AndreiVladescu/LibrePLC32/plc/kicad/LibrePLC32.kicad_pcb

## KiCad design plc/kicad/LibrePLC32.kicad_pcb (2026-08-19)

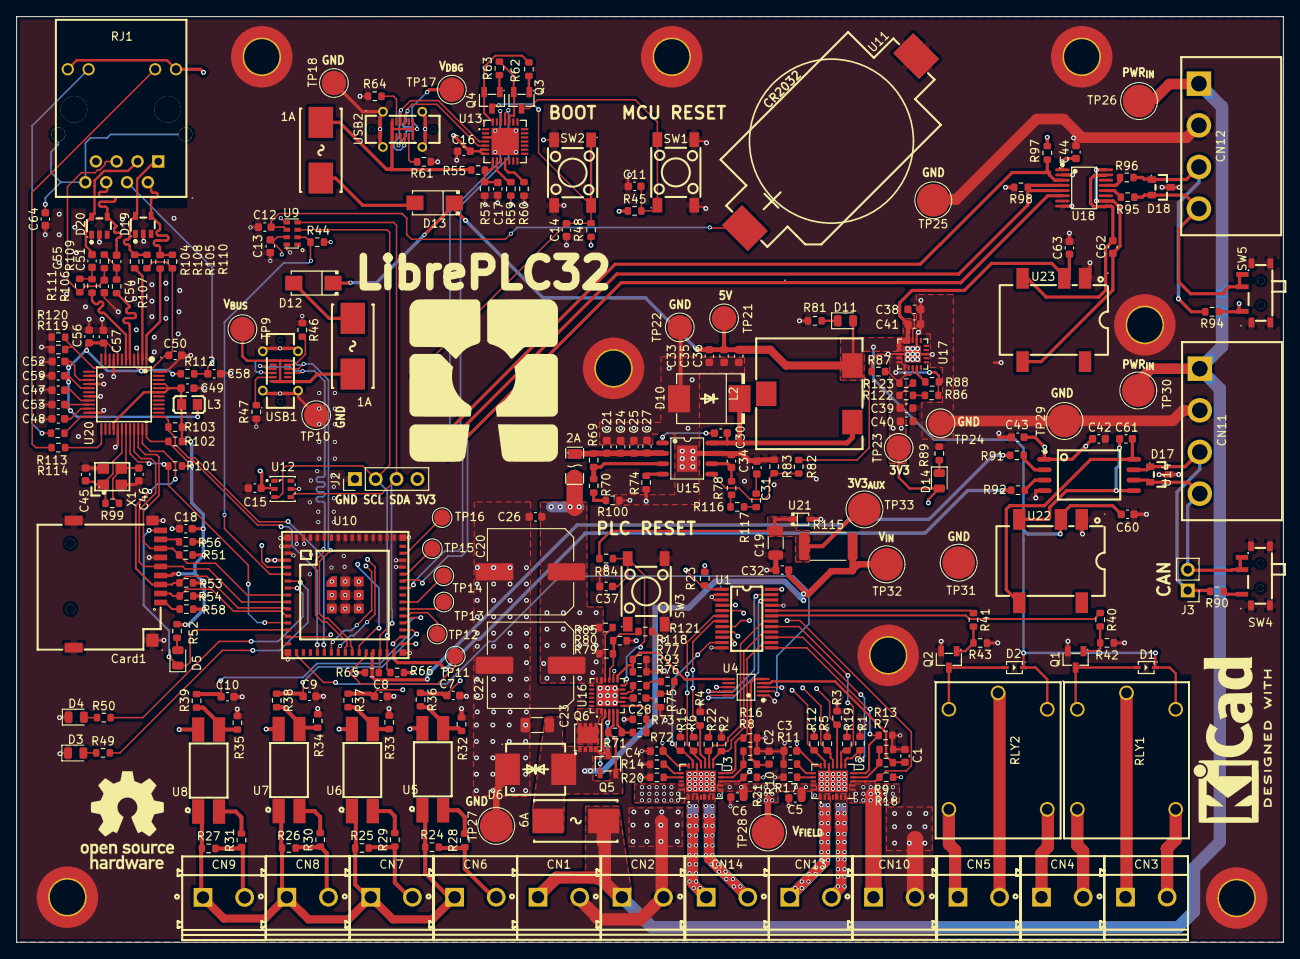
[picture p1: board LibrePLC32.kicad_pcb from above]

Board: 4 copper layers, 154.5 x 112.9 mm, 292 parts (0 on the bottom side), 185 nets.

Parts:
C1, C2: 100p; C_0603_1608Metric
C3, C4, C21, C24, C25, C27: 2.2u; C_0603_1608Metric
C5, C6, C11, C12, C13, C14, C15, C18, C26, C28, C30, C32, C37, C39, C42, C44, C49, C50, C52, C53, C56, C57, C59: 100n; C_0603_1608Metric
C7, C8, C9, C10, C64: 1n; C_0603_1608Metric
C16, C38, C61, C62: 10u; C_0603_1608Metric
C17, C43: 1u; C_0603_1608Metric
C19, C23: 2.2u; C_1206_3216Metric
C20, C22: 220u; C_Elec_10x10.2
C31: 4.7n; C_0603_1608Metric
C33, C35, C36: 47u; C_0603_1608Metric
C34: 47p; C_0603_1608Metric
C40, C41: 22u; C_0603_1608Metric
C45, C46: 27p; C_0603_1608Metric
C47, C60, C63: 4.7u; C_0603_1608Metric
C48, C54: 10n; C_0603_1608Metric
C51, C55: 6.8n; C_0603_1608Metric
C58: 22n; C_0603_1608Metric
CN1, CN2, CN3, CN4, CN5, CN6, CN7, CN8, CN9, CN10, CN13, CN14: DB128V-5.08-2P-GN-S; CONN-TH_2P-P5.08_DIBO_DB128V-5.08
CN11, CN12: DB2ERC-5.08-4P; CONN-TH_4P-P5.08_DB2ERC-5.08-4P
Card1: TF PUSH; TF-SMD_TF-PUSH
D1, D2: 1N4148WS; SOD-323_L1.8-W1.3-LS2.7-RD
D3, D4, D5, D11, D14: LED; LED_0805_2012Metric
D6: SMCJ36CA; SMC_L6.9-W5.9-LS7.9-BI
D10: B560C; SMC_L6.9-W5.9-LS7.9-RD
D12, D13: SS34; SMA_L4.3-W2.7-LS5.1-RD
D17: SM24CANA-02HTG; SOT-23_L2.9-W1.3-P1.90-LS2.4-BR
D18: CDSOT23-SM712; SOT-23_L2.9-W1.3-P1.90-LS2.4-BR
D19, D20: TS3314PLX; SOT-23-5_L2.9-W1.6-P0.95-LS2.8-BR
F2: BSMD1206C-1200T; F1206
FH1, FH2, FH3: 01550900M; FUSE-SMD_L9.8-W5.0_01550900M
H1, H2, H3, H4, H5, H6, H7, H8: MountingHole_Pad; MountingHole_4.3mm_M4_DIN965_Pad_TopBottom
J2: Conn_01x04_Pin; PinHeader_1x04_P2.54mm_Vertical
J3: Conn_01x02_Pin; PinHeader_1x02_P2.54mm_Vertical
L2: 7.2u; IND-SMD_3P-L13.5-W13.0-P6.9
L3: BLM21PG300SN1D; L0805
Q1, Q2: AO3400A; SOT-23-3_L2.9-W1.3-P1.90-LS2.4-BR
Q3, Q4: L8050QLT1G; SOT-23-3_L2.9-W1.3-P1.90-LS2.4-BR
Q5: BSS138LT1G; SOT-23-3_L2.9-W1.6-P1.90-LS2.8-BR
Q6: CSD19537Q3; DFN-8_L3.3-W3.3-P0.65-BL-3
R1, R2, R3, R4, R5, R6, R13, R16, R19, R22, R42, R43, R69, R79, R85, R88: 100k; R_0603_1608Metric
R7, R8, R117: 620; R_0603_1608Metric
R9, R10, R12, R15, R18, R21, R23, R32, R33, R34, R35, R45, R48, R51, R53, R54, R56, R57, R58, R60, R62, R63, R70, R78, R80, R83, R84, R86, R97, R98, R100, R101, R102, R103, R121: 10k; R_0603_1608Metric
R11, R14, R17, R20, R44, R46, R47, R55, R61, R64, R65, R66, R87, R122: 5.1k; R_0603_1608Metric
R24, R25, R26, R27, R28, R29, R30, R31, R77, R116, R118, R119, R120: 6.2k; R_0603_1608Metric
R36, R37, R38, R39, R40, R41, R59, R75, R76, R81, R93, R123: 1k; R_0603_1608Metric
R49, R50, R52, R89, R113, R114: 470; R_0603_1608Metric
R71: 383k; R_0603_1608Metric
R72: 56k; R_0603_1608Metric
R73: 15k; R_0603_1608Metric
R74: 243k; R_0603_1608Metric
R82: 52.5k; R_0603_1608Metric
R90, R94: 120; R_0603_1608Metric
R91, R92: 0; R_0603_1608Metric
R95, R96, R112: 10; R_0603_1608Metric
R99: 1M; R_0603_1608Metric
R104, R105, R106, R107: 33; R_0603_1608Metric
R108, R109, R110, R111: 49; R_0603_1608Metric
R115: 3k; R_2512_6332Metric
RJ1: HR913129A; RJ45-TH_HR913129A
RLY1, RLY2: HF3FF/005-1ZTF; RELAY-TH_HF3FF-018-1ZT
SW1, SW2, SW3: TSD003B08026A03; SW-SMD_4P-L6.0-W6.0-P4.50-LS8.6
SW4, SW5: MSK12C02; SW-TH_MSK12C02
TP9, TP10, TP17, TP18, TP21, TP22, TP23, TP24: TestPoint; TestPoint_Pad_D3.0mm
TP11, TP12, TP13, TP14, TP15, TP16: TestPoint; TestPoint_Pad_D2.0mm
TP25, TP26, TP27, TP28, TP29, TP30, TP31, TP32, TP33: TestPoint; TestPoint_Pad_D4.0mm
U1: TCA9535PWR; TSSOP-24_L7.8-W4.4-P0.65-LS6.4-BL
U2, U3: TPS272C45DRHFR; VQFN-24_L5.0-W4.0-P0.50-BL-EP-1
U4: ADS1115IDGSR; MSOP-10_L3.0-W3.0-P0.50-LS5.0-BL
U5, U6, U7, U8: LTV-814S-TA1-A; OPTO-SMD-4_L4.6-W6.5-P2.54-LS10.3-BL
U9: RV-3028-C7; OSC-SMD_8P-L3.2-W1.5-P0.90-BL
U10: ESP32-S3-MINI-1U; BULETM-SMD_ESPRESSIF_ESP32-S3-MINI-1U-N8
U11: BS-0601-SK-4W; BAT-SMD_BS-06-B4AA012
U12: AHT20; SENSOR-SMD_L3.0-W3.0-P1.00-BR
U13: CP2102N-A02-GQFN28R; QFN-28_L5.0-W5.0-P0.50-TL-EP3.3
U14: ISO1042BDWVR; SOIC-8_L5.9-W7.5-P1.27-LS11.5-BL
U15: TPS54560BDDAR; POWERPAD-SO-8_L4.9-W3.9-P1.27-LS6.0-BL-EP
U16: TPS26630RGER; TQFN-24_L4.0-W4.0-P0.50-TL-EP
U17: TPS7A5201QRGRRQ1; VQFN-20_L3.5-W3.5-P0.50-TL-EP
U18: ISO1500DBQR; SSOP-16_L4.9-W3.9-P0.64-LS6.0-BL
U20: W5500; LQFP-48_L7.0-W7.0-P0.50-LS9.0-BL
U21: BZT52C3V3S; SOD-323_L1.7-W1.3-LS2.5-RD-1
U22, U23: B0505XT-1WR3; PWRM-SMD_BXXXXXT-1WR3
USB1, USB2: GT-USB-7055BB; USB-C-TH_GT-USB-7055BB
X1: X322525MRB4SI; OSC-SMD_4P-L3.2-W2.5-BL_SIT8008BI

Connections:
+3V3: C3.1, C4.1, C13.2, C15.1, C16.2, C18.2, C39.2, C40.2, C42.1, C43.1, C44.1, C49.1, Card1.4 (VDD), D14.2 (A), J2.4, L3.1, R12.1, R15.1, R18.1, R19.1, R21.1, R22.1, R23.1, R44.2, R45.1, R48.1, R51.2, R52.2, R53.2, R54.2, R56.2, R58.2, R59.1, R65.1, R66.1, R86.1, R88.2, R97.1, R101.1, R102.1, R103.1, RJ1.9 (LED(G)_A), RJ1.12 (LED(Y)_A), TP23.1 (1_1), U1.24 (VCC), U2.19 (VDD), U3.19 (VDD), U4.8 (VDD), U5.4, U6.4, U7.4, U8.4, U9.7 (VDD), U10.3 (3V3), U12.2 (VDD), U13.6 (VDD), U13.7 (VREGIN), U14.1 (VCC1), U17.1 (OUT), U17.19 (OUT), U17.20 (OUT), U18.1 (VCC1), U20.28 (VDD), U20.43 (PMODE2), U20.44 (PMODE1), U20.45 (PMODE0)
+3V3A: C50.1, C52.1, C53.1, C56.1, C57.1, C59.1, L3.2, R108.2, R110.2, R112.1, U20.4 (AVDD), U20.8 (AVDD), U20.11 (AVDD), U20.15 (AVDD), U20.17 (AVDD), U20.21 (AVDD)
+3V3_AUX: C19.1, R84.1, R115.1, TP33.1 (1_1), U21.1
+5V: C33.2, C35.2, C36.2, C41.2, C60.1, C63.1, D1.1 (K), D2.1 (K), D11.2 (A), D12.1 (C), D13.1 (C), L2.2, R82.1, RLY1.4, RLY2.4, TP21.1 (1_1), U17.14 (EN), U17.15 (IN), U17.16 (IN), U17.17 (IN), U22.2 (Vin), U23.2 (Vin)
/CAN/CAN_H: CN11.3, D17.1, J3.1, R90.2, U14.7 (CANH)
/CAN/CAN_L: CN11.4, D17.2, J3.2, SW4.2, SW4.3, U14.6 (CANL)
/CAN/CAN_RX: R92.2, U10.30 (IO48)
/CAN/CAN_TX: R91.2, U10.27 (IO47)
/Ethernet/ETH_1V2: C48.1, U20.22 (1V2O)
/Ethernet/ETH_EXPRES: R119.1, R120.1, U20.10 (EXRES1)
/Ethernet/ETH_LED_G: R114.2, U20.25 (LINKLED)
/Ethernet/ETH_LED_Y: R113.2, U20.24 (SPDLED)
/Ethernet/ETH_RX+: R106.1, U20.6 (RXP)
/Ethernet/ETH_RX-: R107.1, U20.5 (RXN)
/Ethernet/ETH_TOCAP: C47.1, U20.20 (TOCAP)
/Ethernet/ETH_TX+: R104.1, U20.2 (TXP)
/Ethernet/ETH_TX-: R105.1, U20.1 (TXN)
/Ethernet/ETH_XI: C45.2, R99.1, U20.30 (XI/CLKIN), X1.1 (OSC1)
/Ethernet/ETH_XO: C46.1, R99.2, U20.31 (XO), X1.3 (OSC2)
/Ethernet/RJ45_RCT: C54.1, R109.1, R111.1, RJ1.5 (RCT)
/Ethernet/RJ45_RX+: C55.2, D20.5, RJ1.3 (RD+)
/Ethernet/RJ45_RX-: C51.2, D20.4, RJ1.6 (RD-)
/Ethernet/RJ45_TCT: C58.1, R112.2, RJ1.4 (TCT)
/Ethernet/RJ45_TX+: D19.5, R104.2, R108.1, RJ1.1 (TD+)
/Ethernet/RJ45_TX-: D19.4, R105.2, R110.1, RJ1.2 (TD-)
/Ethernet/RXN: C51.1, R107.2, R109.2
/Ethernet/RXP: C55.1, R106.2, R111.2
/Ethernet/SPI_MISO: Card1.7 (DAT0), R51.1, U10.8 (IO4), U20.34 (MISO)
/Ethernet/SPI_MOSI: Card1.3 (CMD), R53.1, U10.10 (IO6), U20.35 (MOSI)
/Ethernet/SPI_SCLK: Card1.5 (CLX), U10.9 (IO5), U20.33 (SCLK)
/Ethernet/~ETH_CS: R101.2, U10.12 (IO8), U20.32 (SCSn)
/Ethernet/~ETH_INT: R102.2, U10.19 (IO15), U20.36 (INTn)
/Ethernet/~ETH_RST: R103.2, U10.20 (IO16), U20.37 (RSTn)
/MCU/ADC_RDY: U4.2 (ALERT/RDY), U10.16 (IO12)
/MCU/I2C_SCL: J2.2, R66.2, U1.22 (SCL), U4.10 (SCL), U9.3 (SCL), U10.29 (IO34), U12.3 (SCL)
/MCU/I2C_SDA: J2.3, R65.2, U1.23 (SDA), U4.9 (SDA), U9.4 (SDA), U10.28 (IO33), U12.4 (SDA)
/MCU/MCU_DI1: C7.1, R36.1, U10.31 (IO35)
/MCU/MCU_DI2: C8.1, R37.1, U10.32 (IO36)
/MCU/MCU_DI3: C9.1, R38.1, U10.33 (IO37)
/MCU/MCU_DI4: C10.1, R39.1, U10.34 (IO38)
/MCU/MCU_USB_D+: U10.24 (USB_D+), USB1.A6 (D+), USB1.B6 (D+)
/MCU/MCU_USB_D-: U10.23 (USB_D-), USB1.A7 (D-), USB1.B7 (D-)
/MCU/SD_CD: Card1.CD, D5.1 (K), U10.13 (IO9)
/MCU/SD_DAT1: Card1.8 (DAT1), R56.1
/MCU/SD_DAT2: Card1.1 (DAT2), R58.1
/MCU/S_LED0: R49.2, U10.6 (IO2)
/MCU/S_LED1: R50.2, U10.7 (IO3)
/MCU/UART_DTR: Q4.2 (E), R62.2, U13.28 (DTR)
/MCU/UART_RTS: Q3.2 (E), R63.2, U13.24 (RTS)
/MCU/UART_RX: U10.40 (RXD0), U13.25 (RXD)
/MCU/UART_TX: U10.39 (TXD0), U13.26 (TXD)
/MCU/USB_D+: U13.4 (D+), USB2.A6 (D+), USB2.B6 (D+)
/MCU/USB_D-: U13.5 (D-), USB2.A7 (D-), USB2.B7 (D-)
/MCU/~MCU_BOOT: C14.2, Q4.3 (C), R48.2, SW2.1, SW2.2, U10.4 (IO0)
/MCU/~MCU_RST: C11.2, Q3.3 (C), R45.2, SW1.1, SW1.2
/MCU/~RTC_INT: R44.1, U9.2 (~INT), U10.5 (IO1)
/MCU/~SD_CS: Card1.2 (CD/DAT3), R54.1, U10.11 (IO7)
/Power/FB: R82.2, R83.1, U15.5 (FB)
/Power/MAIN_FB: R87.1, R123.2, U17.3 (FB)
/Power/MAIN_PG: R88.1, U17.4 (PG)
/Power/PPIC_BGATE: Q5.3 (D), Q6.4 (G), U16.3 (BGATE)
/Power/PPIC_DRV: Q5.1 (G), U16.4 (DRV)
/Power/PPIC_ILIM: R93.1, U16.10 (ILIM)
/Power/PPIC_IMON: R77.1, R118.1, U4.6 (AIN2), U16.13 (IMON)
/Power/PPIC_IN: Q6.5 (D), Q6.6 (D), Q6.7 (D), Q6.8 (D), Q6.9 (D), U16.1 (IN), U16.2 (IN)
/Power/PPIC_OVP: R72.2, R73.1, U16.7 (OVP)
/Power/PPIC_PGOOD: R85.2, U16.16 (PGOOD)
/Power/PPIC_PGTH: R79.2, R80.1, R121.1, U16.15 (PGTH)
/Power/PPIC_UVLO: R71.2, R72.1, U16.6 (UVLO)
/Power/PPIC_dVdT: C28.2, U16.9 (dVdT)
/Power/V_IN_MAIN: C23.2, C32.2, D6.2, FH1.2, Q5.2 (S), Q6.1 (S), Q6.2 (S), Q6.3 (S), R71.1, R115.2, TP32.1 (1_1), U16.5 (IN_SYS)
/Power/~PPIC_SHDN: C37.2, R84.2, SW3.2, U16.12 (~SHDN)
/RS-485/EXT_RS485_A: CN12.4, D18.2, R95.1, SW5.2, SW5.3
/RS-485/EXT_RS485_B: CN12.3, D18.1, R94.2, R96.1
/RS-485/RS485_DIR: R98.1, U10.25 (IO21), U18.4 (~RE), U18.5 (DE)
/RS-485/RS485_RXD: R97.2, U10.21 (IO17), U18.3 (R)
/RS-485/RS485_TXD: U10.22 (IO18), U18.6 (D)
/Terminal Blocks Interface/DI1: CN6.2, R24.1, R28.1
/Terminal Blocks Interface/DI2: CN7.2, R25.1, R29.1
/Terminal Blocks Interface/DI3: CN8.2, R26.1, R30.1
/Terminal Blocks Interface/DI4: CN9.2, R27.1, R31.1
/Terminal Blocks Interface/DI_COM: CN6.1, CN7.1, CN8.1, CN9.1, R24.2, R25.2, R26.2, R27.2, U5.1, U6.1, U7.1, U8.1
/Terminal Blocks Interface/MOS_IN1: R40.1, U1.19 (P16)
/Terminal Blocks Interface/MOS_IN2: R41.1, U1.20 (P17)
/Terminal Blocks Interface/REL_DRV1: D1.2 (A), Q1.3 (D), RLY1.1
/Terminal Blocks Interface/REL_DRV2: D2.2 (A), Q2.3 (D), RLY2.1
/Terminal Blocks Interface/RLY1_NC: CN3.2, RLY1.3
/Terminal Blocks Interface/RLY1_NO: CN4.2, RLY1.2
/Terminal Blocks Interface/RLY2_NC: CN4.1, RLY2.3
/Terminal Blocks Interface/RLY2_NO: CN5.1, RLY2.2
/Terminal Blocks Interface/T1_ADC: C1.1, R9.2, U4.4 (AIN0)
/Terminal Blocks Interface/T1_DIA: R13.1, U1.13 (P10), U2.12 (DIA_EN)
/Terminal Blocks Interface/T1_EN1: R5.1, U1.4 (P00), U2.16 (EN1)
/Terminal Blocks Interface/T1_EN2: R3.1, U1.5 (P01), U2.15 (EN2)
/Terminal Blocks Interface/T1_FLT1: R18.2, U1.8 (P04), U2.10 (FLT1)
/Terminal Blocks Interface/T1_FLT2: R12.2, U1.9 (P05), U2.18 (FLT2)
/Terminal Blocks Interface/T1_ILIM1: R17.1, U2.21 (ILIM1)
/Terminal Blocks Interface/T1_ILIM2: R11.1, U2.20 (ILIM2)
/Terminal Blocks Interface/T1_LATCH: R19.2, U1.17 (P14), U2.14 (LATCH)
/Terminal Blocks Interface/T1_OUT1: CN13.1, U2.1 (OUT1), U2.2 (OUT1), U2.3 (OUT1)
/Terminal Blocks Interface/T1_OUT2: CN13.2, U2.5 (OUT2), U2.6 (OUT2), U2.7 (OUT2)
/Terminal Blocks Interface/T1_SEL: R1.1, U1.15 (P12), U2.13 (SEL)
/Terminal Blocks Interface/T1_SNS: R7.1, R9.1, U2.11 (SNS)
/Terminal Blocks Interface/T2_ADC: C2.1, R10.2, U4.5 (AIN1)
/Terminal Blocks Interface/T2_DIA: R16.1, U1.14 (P11), U3.12 (DIA_EN)
/Terminal Blocks Interface/T2_EN1: R6.1, U1.6 (P02), U3.16 (EN1)
/Terminal Blocks Interface/T2_EN2: R4.1, U1.7 (P03), U3.15 (EN2)
/Terminal Blocks Interface/T2_FLT1: R21.2, U1.10 (P06), U3.10 (FLT1)
/Terminal Blocks Interface/T2_FLT2: R15.2, U1.11 (P07), U3.18 (FLT2)
/Terminal Blocks Interface/T2_ILIM1: R20.1, U3.21 (ILIM1)
/Terminal Blocks Interface/T2_ILIM2: R14.1, U3.20 (ILIM2)
/Terminal Blocks Interface/T2_LATCH: R22.2, U1.18 (P15), U3.14 (LATCH)
/Terminal Blocks Interface/T2_OUT1: CN14.1, U3.1 (OUT1), U3.2 (OUT1), U3.3 (OUT1)
/Terminal Blocks Interface/T2_OUT2: CN14.2, U3.5 (OUT2), U3.6 (OUT2), U3.7 (OUT2)
/Terminal Blocks Interface/T2_SEL: R2.1, U1.16 (P13), U3.13 (SEL)
/Terminal Blocks Interface/T2_SNS: R8.1, R10.1, U3.11 (SNS)
/Terminal Blocks Interface/~GPIO_MUX_INT: R23.2, U1.1 (~INT), U10.14 (IO10)
Earth: C64.2, RJ1.8 (CHSGND), RJ1.13 (SHILED), RJ1.14 (SHILED)
GND: C1.2, C2.2, C3.2, C4.2, C5.2, C6.2, C7.2, C8.2, C9.2, C10.2, C11.1, C12.1, C13.1, C14.1, C15.2, C16.1, C17.2, C18.1, C19.2, C20.2, C21.2, C22.2, C23.1, C24.2, C25.2, C26.1, C27.2, C28.1, C31.1, C32.1, C33.1, C34.1, C35.1, C36.1, C37.1, C38.1, C39.1, C40.1, C41.1, C42.2, C43.2, C44.2, C45.1, C46.2, C47.2, C48.2, C49.2, C50.2, C52.2, C53.2, C54.2, C56.2, C57.2, C58.2, C59.2, C60.2, C63.2, C64.1, CN1.2, CN2.2, CN10.2, CN11.2, CN12.2, Card1.6 (VSS), Card1.10, Card1.11, Card1.12, Card1.13, D3.1 (K), D4.1 (K), D6.1, D10.2 (A), D17.3, D18.3, D19.2, D20.2, H1.1 (1_1), H2.1 (1_1), H3.1 (1_1), H4.1 (1_1), H5.1 (1_1), H6.1 (1_1), H7.1 (1_1), H8.1 (1_1), J2.1, Q1.2 (S), Q2.2 (S), R1.2, R2.2, R3.2, R4.2, R5.2, R6.2, R7.2, R8.2, R11.2, R13.2, R14.2, R16.2, R17.2, R20.2, R32.1, R33.1, R34.1, R35.1, R42.1, R43.1, R46.1, R47.2, R57.1, R60.1, R61.1, R64.2, R73.2, R74.2, R75.2, R77.2, R80.2, R81.2, R83.2, R87.2, R89.2, R98.2, R100.2, R118.2, R119.2, R120.2, R121.2, SW1.3, SW1.4, SW2.3, SW2.4, SW3.3, SW3.4, SW4.4, SW5.4, TP10.1 (1_1), TP18.1 (1_1), TP22.1 (1_1), TP24.1 (1_1), TP25.1 (1_1), TP27.1 (1_1), TP29.1 (1_1), TP31.1 (1_1), U1.2 (A1), U1.3 (A2), U1.12 (GND), U1.21 (A0), U2.17 (GND), U2.25 (EP), U3.17 (GND), U3.25 (EP), U4.1 (ADDR), U4.3 (GND), U9.5 (VSS), U9.8 (EVI), U10.1 (GND), U10.2 (GND), U10.42 (GND), U10.43 (GND), U10.46 (GND), U10.47 (GND), U10.48 (GND), U10.49 (GND), U10.50 (GND), U10.51 (GND), U10.52 (GND), U10.53 (GND), U10.54 (GND), U10.55 (GND), U10.56 (GND), U10.57 (GND), U10.58 (GND), U10.59 (GND), U10.60 (GND), U10.61 (GND), U10.62 (GND), U10.63 (GND), U10.64 (GND), U10.65 (GND), U11.2, U12.5 (GND), U13.3 (GND), U13.29 (EP), U14.4 (GND1), U15.7 (GND), U15.9 (EP), U16.8 (GND), U16.11 (MODE), U16.14 (~FLT), U16.25 (EP), U17.8 (GND), U17.12 (BIAS), U17.18 (GND), U17.21 (EP), U18.2 (GND1), U18.8 (GND1), U20.3 (AGND), U20.9 (AGND), U20.14 (AGND), U20.16 (AGND), U20.19 (AGND), U20.23 (RSVD), U20.29 (GND), U20.48 (AGND), U21.2, U22.1 (GND), U23.1 (GND), USB1.17 (EH), USB1.A1 (GND), USB1.A12 (GND), USB1.B1 (GND), USB1.B12 (GND), USB2.17 (EH), USB2.A1 (GND), USB2.A12 (GND), USB2.B1 (GND), USB2.B12 (GND), X1.2 (GND), X1.4 (GND)
ISO_CAN+: C61.1, U14.8 (VCC2), U22.5 (+Vo)
ISO_CAN-: C61.2, U14.5 (GND2), U22.4 (-Vo)
ISO_RS485+: C62.1, U18.10 (VCC2), U18.16 (VCC2), U23.5 (+Vo)
ISO_RS485-: C62.2, U18.9 (GND2), U18.15 (GND2), U23.4 (-Vo)
unnamed: C31.2, R117.2
unnamed: CN3.1, RLY1.5
unnamed: CN5.2, RLY2.5
unnamed: D3.2 (A), R49.1
unnamed: D4.2 (A), R50.1
unnamed: D5.2 (A), R52.1
unnamed: C30.2, D10.1 (K), L2.1, U15.8 (SW)
unnamed: D11.1 (K), R81.1
unnamed: D12.2 (A), FH2.1
unnamed: D13.2 (A), FH3.1
unnamed: D14.1 (K), R89.1
unnamed: Q1.1 (G), R40.2, R42.2
unnamed: Q2.1 (G), R41.2, R43.2
unnamed: Q3.1 (B), R62.1
unnamed: Q4.1 (B), R63.1
unnamed: R28.2, U5.2
unnamed: R29.2, U6.2
unnamed: R30.2, U7.2
unnamed: R31.2, U8.2
unnamed: R32.2, R36.2, U5.3
unnamed: R33.2, R37.2, U6.3
unnamed: R34.2, R38.2, U7.3
unnamed: R35.2, R39.2, U8.3
unnamed: R75.1, R76.2
unnamed: R76.1, R93.2
unnamed: R90.1, SW4.1
unnamed: R94.1, SW5.1
unnamed: R70.2, R100.1
unnamed: R78.2, R116.1
unnamed: R116.2, R117.1
unnamed: R86.2, R122.1
unnamed: R122.2, R123.1
unnamed: R114.1, RJ1.10 (LED(G)_K)
unnamed: R113.1, RJ1.11 (LED(Y)_K)
unnamed: TP11.1 (1_1), U10.26 (IO26)
unnamed: TP12.1 (1_1), U10.35 (IO39)
unnamed: TP13.1 (1_1), U10.36 (IO40)
unnamed: TP14.1 (1_1), U10.37 (IO41)
unnamed: TP15.1 (1_1), U10.41 (IO45)
unnamed: TP16.1 (1_1), U10.44 (IO46)
unnamed: R59.2, U13.9 (RSTb)
unnamed: R60.2, U13.11 (SUSPENDb)
unnamed: C17.1, R55.2, R57.2, U13.8 (VBUS)
unnamed: R92.1, U14.3 (RXD)
unnamed: R91.1, U14.2 (TXD)
unnamed: C30.1, U15.1 (BOOT)
unnamed: C34.2, R78.1, U15.6 (COMP)
unnamed: R69.2, R70.1, U15.3 (EN)
unnamed: R74.1, U15.4 (RT/CLK)
unnamed: C21.1, C24.1, C25.1, C27.1, F2.1, R69.1, U15.2 (VIN)
unnamed: C38.2, U17.13 (NR/SS)
unnamed: R95.2, U18.12 (A)
unnamed: R96.2, U18.13 (B)
unnamed: R47.1, USB1.A5 (CC1)
unnamed: R46.2, USB1.B5 (CC2)
unnamed: R64.1, USB2.A5 (CC1)
unnamed: R61.2, USB2.B5 (CC2)
PWR_CAN: CN1.1, CN2.1, CN11.1, CN12.1, FH1.1, TP26.1 (1_1), TP30.1 (1_1)
VBUS: FH2.2, TP9.1 (1_1), USB1.A4 (VBUS), USB1.A9 (VBUS), USB1.B4 (VBUS), USB1.B9 (VBUS)
VDBG: FH3.2, R55.1, TP17.1 (1_1), USB2.A4 (VBUS), USB2.A9 (VBUS), USB2.B4 (VBUS), USB2.B9 (VBUS)
V_FIELD: C5.1, C6.1, C20.1, C22.1, C26.2, CN10.1, F2.2, R79.1, R85.1, TP28.1 (1_1), U2.8 (VS), U2.9 (VS), U2.23 (VS), U2.24 (VS), U3.8 (VS), U3.9 (VS), U3.23 (VS), U3.24 (VS), U16.17 (OUT), U16.18 (OUT)
Vbat: C12.2, U9.6 (VBACKUP), U11.1
