AndreiVladescu/LibrePLC32/(commit log)

2026-04-09 Added initial design
    [LibrePLC32.kicad_pcb, LibrePLC32.kicad_sch, can.kicad_sch, ethernet.kicad_sch, mcu.kicad_sch, power.kicad_sch, rs-485.kicad_sch, terminal_blocks_interface.kicad_sch]
2026-04-10 Added transistor outputs
    [mcu.kicad_sch, terminal_blocks_interface.kicad_sch]
2026-04-10 Added gpio multiplexer and relay circuit
    [LibrePLC32.kicad_sch, mcu.kicad_sch, terminal_blocks_interface.kicad_sch]
2026-04-10 Updated ethernet circuit
    [LibrePLC32.kicad_sch, ethernet.kicad_sch, mcu.kicad_sch, terminal_blocks_interface.kicad_sch]
2026-04-10 Added RS 485 circuit
    [LibrePLC32.kicad_sch, mcu.kicad_sch, rs-485.kicad_sch]
2026-04-10 Added CAN circuit
    [LibrePLC32.kicad_sch, can.kicad_sch, mcu.kicad_sch, power.kicad_sch, rs-485.kicad_sch]
2026-04-10 Added buck converter circuit
    [LibrePLC32.kicad_sch, power.kicad_sch]
2026-04-11 Added netclasses
    [can.kicad_sch, ethernet.kicad_sch, power.kicad_sch, rs-485.kicad_sch, terminal_blocks_interface.kicad_sch]
2026-04-11 Added the power protection IC
    [LibrePLC32.kicad_sch, ethernet.kicad_sch, power.kicad_sch, terminal_blocks_interface.kicad_sch]
2026-04-11 Wired ESP32-S3 preliminarily
    [LibrePLC32.kicad_sch, mcu.kicad_sch, power.kicad_sch, terminal_blocks_interface.kicad_sch]
2026-04-11 Added CP2102N bridge
    [can.kicad_sch, ethernet.kicad_sch, mcu.kicad_sch, power.kicad_sch, rs-485.kicad_sch, terminal_blocks_interface.kicad_sch]
2026-04-11 Added 3.3V regulator
    [can.kicad_sch, ethernet.kicad_sch, mcu.kicad_sch, power.kicad_sch, rs-485.kicad_sch, terminal_blocks_interface.kicad_sch]
2026-04-12 AHT20 sensor added
    [LibrePLC32.kicad_pcb, can.kicad_sch, ethernet.kicad_sch, mcu.kicad_sch, power.kicad_sch, rs-485.kicad_sch, terminal_blocks_interface.kicad_sch]
2026-04-12 Added more testpads
    [mcu.kicad_sch, power.kicad_sch]
2026-04-12 Added another power connector
    [terminal_blocks_interface.kicad_sch]
2026-04-12 Added RTC IC
    [mcu.kicad_sch, power.kicad_sch]
2026-04-12 PCB placement
    [LibrePLC32.kicad_pcb, LibrePLC32.kicad_sch, can.kicad_sch, ethernet.kicad_sch, mcu.kicad_sch, power.kicad_sch, rs-485.kicad_sch, terminal_blocks_interface.kicad_sch]
2026-04-17 Revised CAN circuit
    [can.kicad_sch]
2026-04-18 RS485 circuit reviewed
    [rs-485.kicad_sch]
2026-08-18 Added i2c addresses & TPS26630 modifications
    [LibrePLC32.kicad_pcb, mcu.kicad_sch, power.kicad_sch]
2026-08-19 Needed fixes
    [LibrePLC32.kicad_pcb, mcu.kicad_sch]
